Sean-KSH/UMD-2025-Modular-PID-Heater/BOM.xlsx

Category | Part | Notes | Link Example
Power Supply | 12V 5A DC | Powers both heater and Microcontroller | 12V 5A Power Source (https://www.amazon.com/Converter-Transformer-100-240v-5-5x2-5mm-Security/dp/B0CW2PJQLJ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)
Heating Element | 12V 60W Silicone Pad | Draws ~5A at 12V. Good surface coverage. | Adafruit Silicone Heater (https://www.adafruit.com/product/1481)
Microcontroller | Arduino Nano Every | 5V logic. Reads thermistor via analog pin and outputs PWM to heater. | Arduino Nano Every in lab | AtMega 4809-AF (https://www.mouser.com/ProductDetail/Microchip-Technology/ATMEGA4809-AF?qs=P1JMDcb91o7OeioEO5GiOg%3D%3D) | ESP32 DevKit (https://www.mouser.com/ProductDetail/Espressif-Systems/ESP32-S3-DevKitM-1U-N8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)
MOSFET | IRLZ44N | Logic-level N-channel, supports >20A. | IRLZ44NPBF (https://www.mouser.com/ProductDetail/Infineon-Technologies/IRLZ44NPBF?qs=9%252BKlkBgLFf15OZZk%252BD0ibg%3D%3D)
Flyback Diode | 1N5819 | Across heater to protect from voltage spikes. | 1N5819 (https://www.mouser.com/ProductDetail/STMicroelectronics/1N5819?qs=G5AQjGfRJcKKUy9S%252BaTHRQ%3D%3D)
Thermistor | 10kΩ NTC (3950 B-value) | Widely supported and accurate below 150°C. | 10k NTC 3950 Thermistor (https://www.mouser.com/ProductDetail/Eaton-Electronics/NRL1104F3950B1F?qs=doiCPypUmgEuCf4XSmCqaQ%3D%3D)
Voltage Divider Resistor | 10kΩ 1% metal film | Matches thermistor nominal resistance for better accuracy. | 10kΩ Resistor (https://www.mouser.com/ProductDetail/YAGEO/MFR-25FRF52-10K?qs=5furm%2FeQHzSFNehIjUjbug%3D%3D)
LCD Display | I2C 16x2 LCD | For temperature, setpoint, and heater output display. | I2C LCD Module (https://www.adafruit.com/product/181)
Switches | SPST Toggle or Rocker | One each for Arduino and heater power. | Mini Toggle Switch (https://www.mouser.com/ProductDetail/Dailywell/2MS6T1B3M2QES?qs=B6kkDfuK7%2FCLnLIcqzvQEQ%3D%3D)
Capacitor | 100nF Ceramic | Across heater terminals to reduce EMI. | 100nF Capacitor (https://www.mouser.com/ProductDetail/Vishay-BC-Components/K104K10X7RF5UL2?qs=YhDfSRCt1jTknXI4uF2hrw%3D%3D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)
Terminal Blocks | 2/3-pin scr | Allows interchangeable use of heating element | In Lab
Buck Converter | LM2596 | Steps down input voltage from source to microcontroller compatible | 3.3V Buck Converter (https://www.mouser.com/ProductDetail/Texas-Instruments/LM2596S-33-NOPB?qs=X1J7HmVL2ZHsEwG9Q6doow%3D%3D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)
Buck Converter | LM2596 | Steps down input voltage from source to microcontroller compatible | 5V Buck Converter (https://www.mouser.com/ProductDetail/Texas-Instruments/LM2596SX-5.0-NOPB?qs=X1J7HmVL2ZGZ5T4VcWdmNw%3D%3D)
Rotary Encoder | WayinTop | Allows adjustable resistance for temperature setting | Rotary Encoder (https://www.amazon.com/dp/B08728K3YB/)
Breadboard & Wires |  | Prototyping | Breadboard and Wires (https://www.amazon.com/BOJACK-Values-Solderless-Breadboard-Flexible/dp/B08Y59P6D1)
Wirestrippers |  | Prototyping | Wirestrippers (https://www.amazon.com/WGGE-Professional-crimping-Multi-Tool-Multi-Function/dp/B073YG65N2?s=industrial)
Fuse |  | Safety | Fuse (https://www.mouser.com/ProductDetail/Bel-Fuse/0HAAL5000-02)
